lhr-solar/VCAT-MIKA/Hardware/MIKA/3D Models/TPS37A543222DSKRQ1.stp

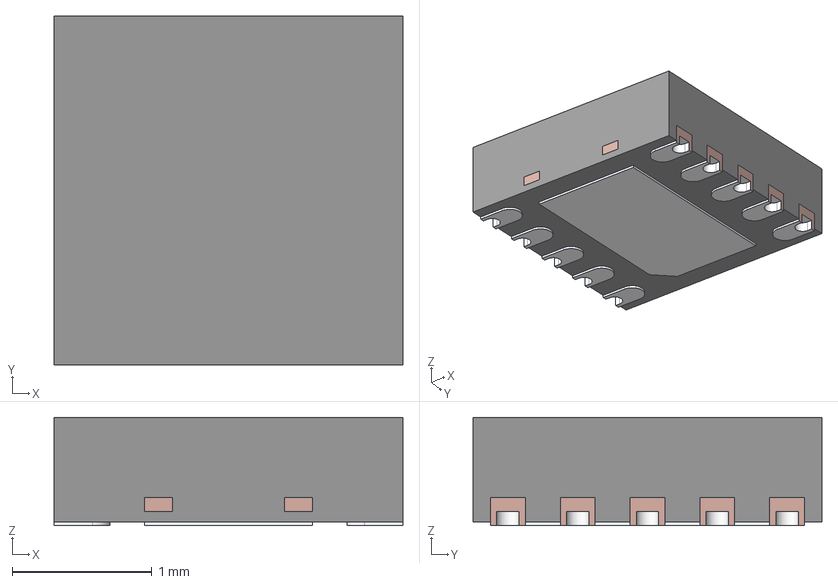
[picture p1: CAD file, 2026-10-27]
Hardware/MIKA/3D Models/TPS37A543222DSKRQ1.stp
2.50 x 2.50 x 0.775 mm
BODY-SON
FRAME-DSK0010C
