lhr-solar/VCAT-MIKA/Hardware/MIKA/3D Models/TPS2557QDRBTQ1.stp

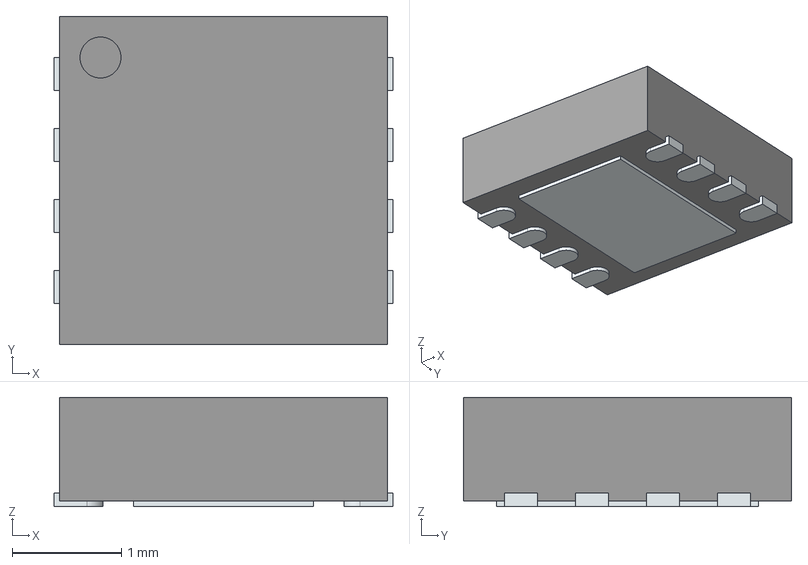
[picture p2: CAD file, 2026-10-13]
Hardware/MIKA/3D Models/TPS2557QDRBTQ1.stp
3.10 x 3.00 x 1.00 mm
ThermalPin
PinsArrayLR
