lhr-solar/VCAT-MIKA/Hardware/MIKA/3D Models/TPS566238RQFR.stp

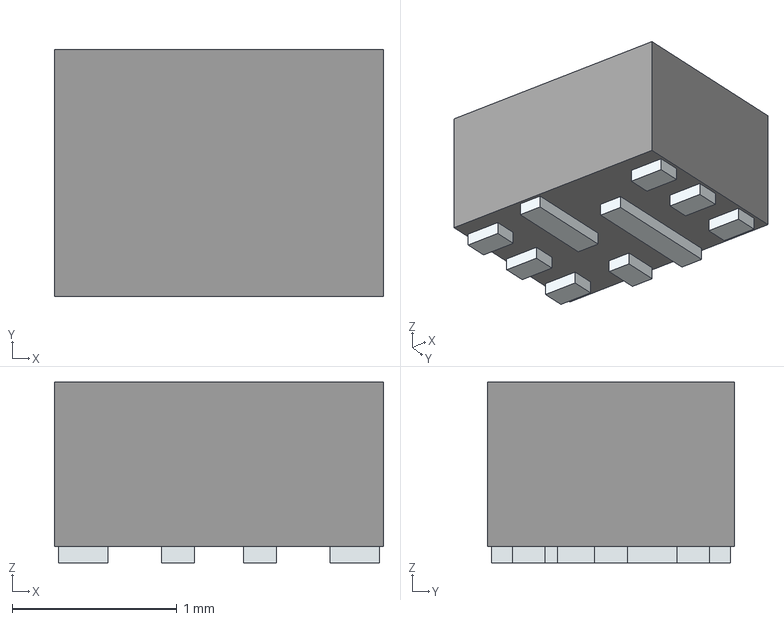
[picture p3: CAD file, 2026-10-27]
Hardware/MIKA/3D Models/TPS566238RQFR.stp
2.00 x 1.50 x 1.10 mm
Pins
