lhr-solar/VCAT-MIKA/Hardware/MIKA/3D Models/TPS259480AYWPR.stp

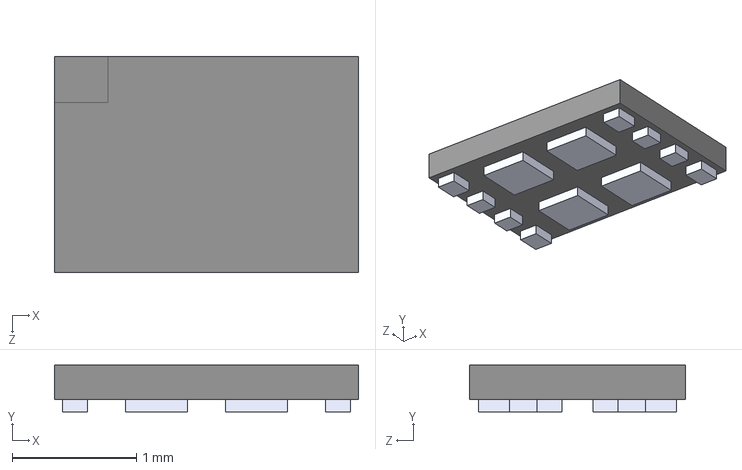
[picture p4: CAD file, 2026-10-27]
Hardware/MIKA/3D Models/TPS259480AYWPR.stp
2.45 x 0.376 x 1.74 mm
