lhr-solar/VCAT-MIKA/Hardware/MIKA/3D Models/TPS56628DDAR.stp

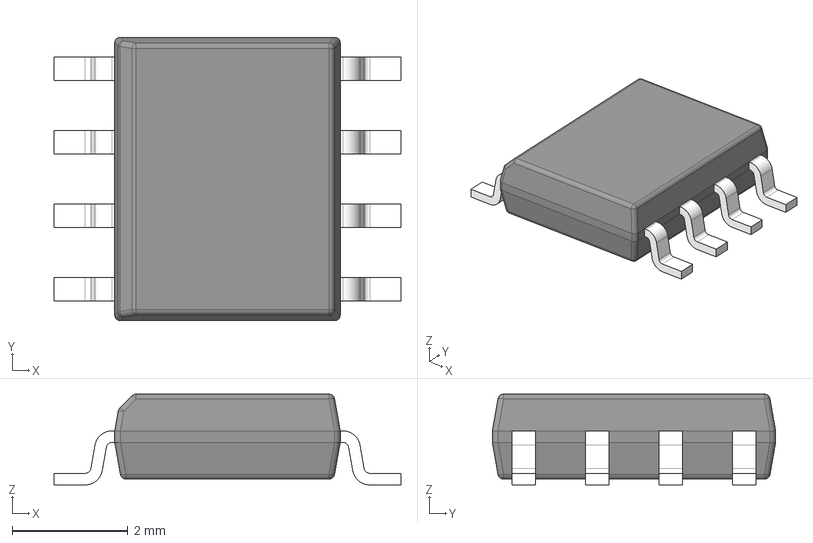
[picture p5: CAD file, 2026-10-27]
Hardware/MIKA/3D Models/TPS56628DDAR.stp
6.00 x 4.90 x 1.57 mm
BODY-SO
LEAD-SO x 8
THERMALPAD-SO
