lhr-solar/VCAT-MIKA/Hardware/MIKA/12V_buck_5A.kicad_sch

## KiCad design Hardware/MIKA/12V_buck_5A.kicad_sch (2026-10-31)

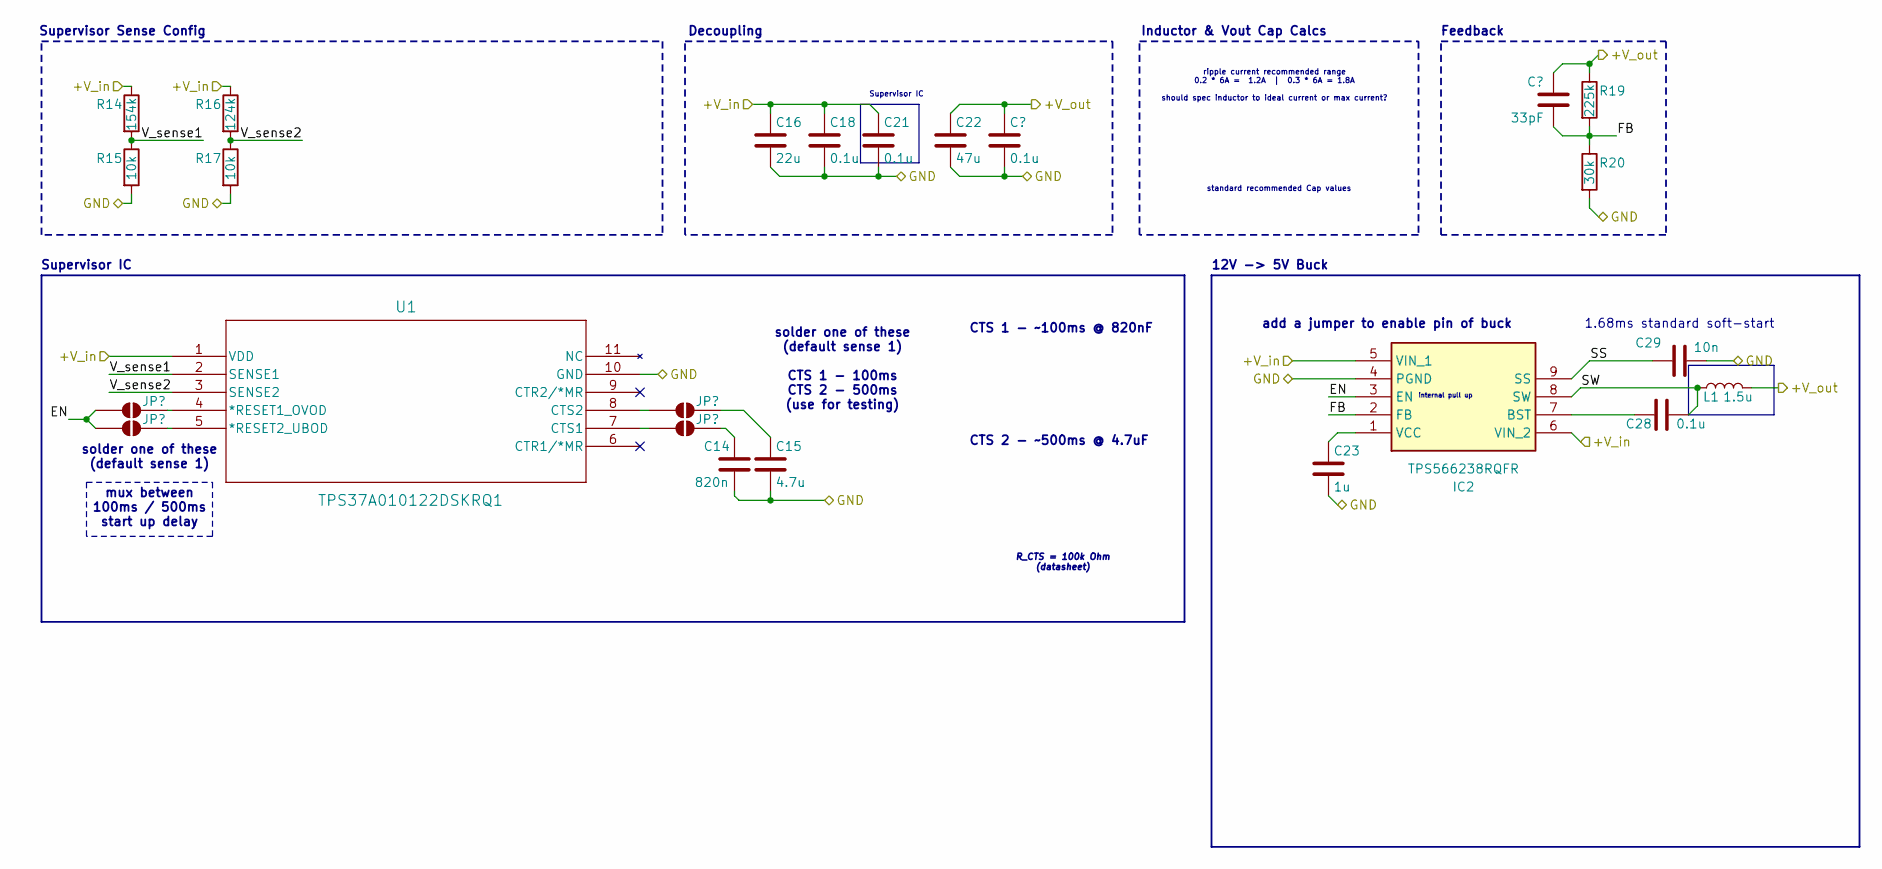
[picture p6: schematic 12V_buck_5A.kicad_sch]

Parts:
C14: 820n
C15: 4.7u
C16: 22u
C18, C21, C28: 0.1u
C22: 47u
C23: 1u
C29: 10n
IC2: TPS566238RQFR; Mouser Part Number 595-TPS566238RQFR
L1: 1.5u
R14: 154k
R15, R17: 10k
R16: 124k
R19: 225k
R20: 30k
U1: TPS37A010122DSKRQ1; SON10_DSK_TEX

Connections:
+V_in: C16.1, C18.1, C21.1, IC2.5 (VIN_1), IC2.6 (VIN_2), R14.1, R16.1, U1.1 (VDD)
+V_out: C22.1, L1.2, R19.1
EN: IC2.3 (EN)
FB: IC2.2 (FB), R19.2, R20.1
GND: C14.2, C15.2, C16.2, C18.2, C21.2, C22.2, C23.2, C29.1, IC2.4 (PGND), R15.2, R17.2, R20.2, U1.10 (GND)
unnamed: C23.1, IC2.1 (VCC)
unnamed: C28.1, IC2.7 (BST)
SS: C29.2, IC2.9 (SS)
SW: C28.2, IC2.8 (SW), L1.1
V_sense1: R14.2, R15.1, U1.2 (SENSE1)
V_sense2: R16.2, R17.1, U1.3 (SENSE2)

Notes on the sheet:
Supervisor IC
Feedback
solder one of these (default sense 1) CTS 1 - 100ms CTS 2 - 500ms (use for testing)
Decoupling
standard recommended Cap values
Inductor & Vout Cap Calcs
R_CTS = 100k Ohm (datasheet)
Supervisor Sense Config
12V -> 5V Buck
CTS 1 - ~100ms @ 820nF
ripple current recommended range 0.2 * 6A = 1.2A | 0.3 * 6A = 1.8A should spec inductor to ideal current or max current?
solder one of these (default sense 1) mux between 100ms / 500ms start up delay
1.68ms standard soft-start
internal pull up
add a jumper to enable pin of buck
CTS 2 - ~500ms @ 4.7uF
