lhr-solar/VCAT-MIKA/Hardware/MIKA/CM5.kicad_sch

## KiCad design Hardware/MIKA/CM5.kicad_sch (2026-10-31)

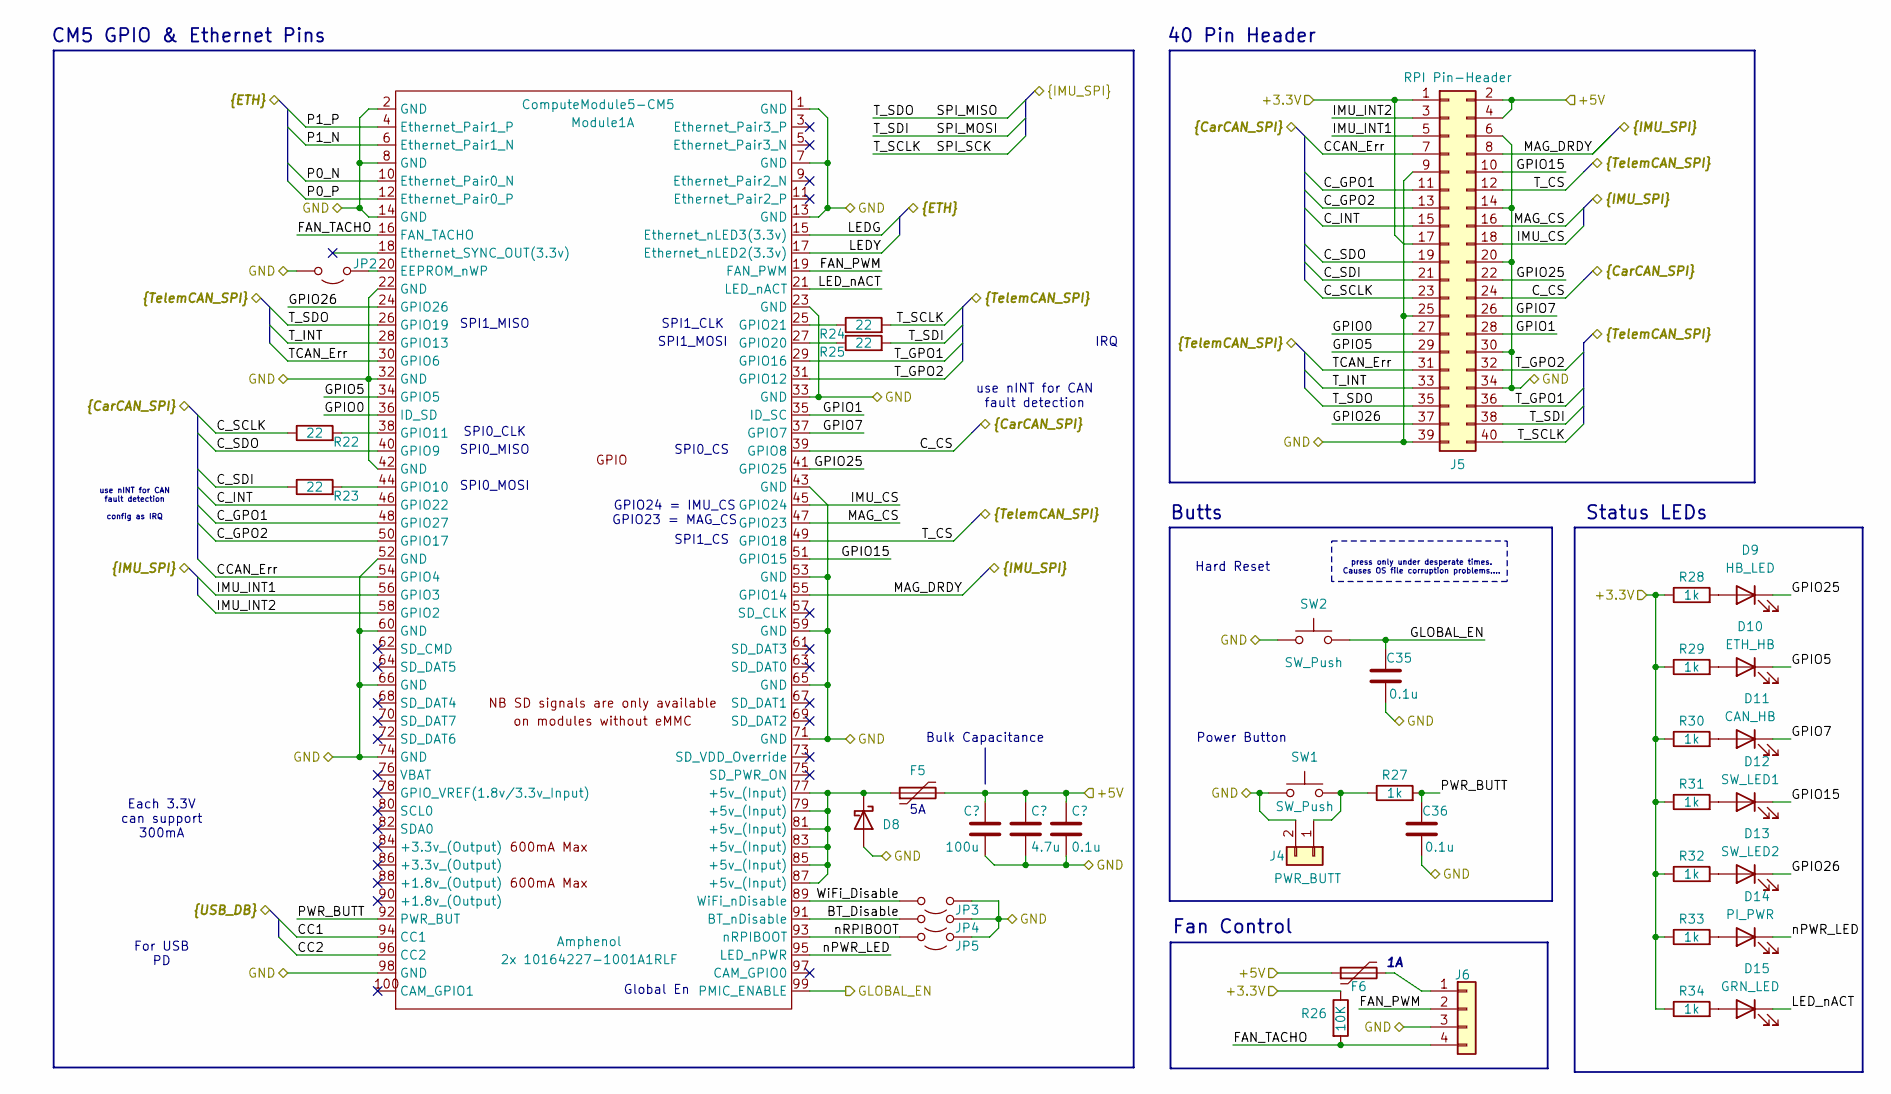
[picture p7: schematic CM5.kicad_sch]

Parts:
C35, C36: 0.1u
D8: D_Schottky
D9: HB_LED
D10: ETH_HB
D11: CAN_HB
D12: SW_LED1
D13: SW_LED2
D14: PI_PWR
D15: GRN_LED
F5, F6: Polyfuse
J4: PWR_BUTT
J5: RPI Pin-Header; PinSocket_2x20_P2.54mm_Vertical; JLC N/A
J6: Fan Header; JST_SH_BM04B-SRSS-TB_1x04-1MP_P1.00mm_Vertical; Part Description 4 pin vertical 1mm pitch connector; JLC N/A
JP2, JP3, JP4, JP5: Jumper_2_Open
Module1: ComputeModule5-CM5; Raspberry-Pi-5-Compute-Module
R22, R23, R24, R25: 22
R26: 10K
R27, R28, R29, R30, R31, R32, R33, R34: 1k
SW1, SW2: SW_Push

Connections:
+3.3V: J5.1, J5.17, R26.1, R28.1, R29.1, R30.1, R31.1, R32.1, R33.1, R34.1
+5V: F5.2, F6.1, J5.2, J5.4
BT_Disable: JP4.2 (B), Module1.91 (BT_nDisable)
CC1: Module1.94 (CC1)
CC2: Module1.96 (CC2)
CCAN_Err: J5.7, Module1.54 (GPIO4)
C_CS: J5.24, Module1.39 (GPIO8)
C_GPO1: J5.11, Module1.48 (GPIO27)
C_GPO2: J5.13, Module1.50 (GPIO17)
C_INT: J5.15, Module1.46 (GPIO22)
C_SCLK: J5.23, R22.1
C_SDI: J5.21, R23.1
C_SDO: J5.19, Module1.40 (GPIO9)
FAN_PWM: J6.2, Module1.19 (FAN_PWM)
FAN_TACHO: J6.4, Module1.16 (FAN_TACHO), R26.2
GLOBAL_EN: C35.2, Module1.99 (PMIC_ENABLE), SW2.2
GND: C35.1, C36.1, D8.2 (A), J4.2, J5.6, J5.9, J5.14, J5.20, J5.25, J5.30, J5.34, J5.39, J6.3, JP2.2 (B), JP3.1 (A), JP4.1 (A), JP5.1 (A), Module1.1 (GND), Module1.2 (GND), Module1.7 (GND), Module1.8 (GND), Module1.13 (GND), Module1.14 (GND), Module1.22 (GND), Module1.23 (GND), Module1.32 (GND), Module1.33 (GND), Module1.42 (GND), Module1.43 (GND), Module1.52 (GND), Module1.53 (GND), Module1.59 (GND), Module1.60 (GND), Module1.65 (GND), Module1.66 (GND), Module1.71 (GND), Module1.74 (GND), Module1.98 (GND), SW1.1, SW2.1
GPIO0: J5.27, Module1.36 (ID_SD)
GPIO1: J5.28, Module1.35 (ID_SC)
GPIO5: D10.1 (K), J5.29, Module1.34 (GPIO5)
GPIO7: D11.1 (K), J5.26, Module1.37 (GPIO7)
GPIO15: D12.1 (K), J5.10, Module1.51 (GPIO15)
GPIO25: D9.1 (K), J5.22, Module1.41 (GPIO25)
GPIO26: D13.1 (K), J5.37, Module1.24 (GPIO26)
IMU_CS: J5.18, Module1.45 (GPIO24)
IMU_INT1: J5.5, Module1.56 (GPIO3)
IMU_INT2: J5.3, Module1.58 (GPIO2)
LEDG: Module1.15 (Ethernet_nLED3(3.3v))
LEDY: Module1.17 (Ethernet_nLED2(3.3v))
LED_nACT: D15.1 (K), Module1.21 (LED_nACT)
MAG_CS: J5.16, Module1.47 (GPIO23)
MAG_DRDY: J5.8, Module1.55 (GPIO14)
unnamed: D8.1 (K), F5.1, Module1.77 (+5v_(Input)), Module1.79 (+5v_(Input)), Module1.81 (+5v_(Input)), Module1.83 (+5v_(Input)), Module1.85 (+5v_(Input)), Module1.87 (+5v_(Input))
unnamed: D9.2 (A), R28.2
unnamed: D10.2 (A), R29.2
unnamed: D11.2 (A), R30.2
unnamed: D12.2 (A), R31.2
unnamed: D13.2 (A), R32.2
unnamed: D14.2 (A), R33.2
unnamed: D15.2 (A), R34.2
unnamed: F6.2, J6.1
unnamed: J4.1, R27.1, SW1.2
unnamed: JP2.1 (A), Module1.20 (EEPROM_nWP)
unnamed: Module1.25 (GPIO21), R24.1
unnamed: Module1.27 (GPIO20), R25.1
unnamed: Module1.38 (GPIO11), R22.2
unnamed: Module1.44 (GPIO10), R23.2
P0_N: Module1.10 (Ethernet_Pair0_N)
P0_P: Module1.12 (Ethernet_Pair0_P)
P1_N: Module1.6 (Ethernet_Pair1_N)
P1_P: Module1.4 (Ethernet_Pair1_P)
PWR_BUTT: C36.2, Module1.92 (PWR_BUT), R27.2
SPI_MISO: J5.35, Module1.26 (GPIO19)
SPI_MOSI: J5.38, R25.2
SPI_SCK: J5.40, R24.2
TCAN_Err: J5.31, Module1.30 (GPIO6)
T_CS: J5.12, Module1.49 (GPIO18)
T_GPO1: J5.36, Module1.29 (GPIO16)
T_GPO2: J5.32, Module1.31 (GPIO12)
T_INT: J5.33, Module1.28 (GPIO13)
WiFi_Disable: JP3.2 (B), Module1.89 (WiFi_nDisable)
nPWR_LED: D14.1 (K), Module1.95 (LED_nPWR)
nRPIBOOT: JP5.2 (B), Module1.93 (nRPIBOOT)

Notes on the sheet:
IRQ
SPI0_CLK
40 Pin Header
Each 3.3V can support 300mA
SPI1_CS
Fan Control
SPI0_MISO
CM5 GPIO & Ethernet Pins
SPI1_CLK
Power Button
SPI1_MOSI
press only under desperate times. Causes OS file corruption problems....
use nINT for CAN fault detection config as IRQ
Butts
Bulk Capacitance
SPI1_MISO
Global En
Hard Reset
For USB PD
SPI0_CS
GPIO24 = IMU_CS GPIO23 = MAG_CS
use nINT for CAN fault detection
SPI0_MOSI
Status LEDs
