lhr-solar/VCAT-MIKA/Hardware/MIKA/IMUs.kicad_sch

## KiCad design Hardware/MIKA/IMUs.kicad_sch (2026-10-27)

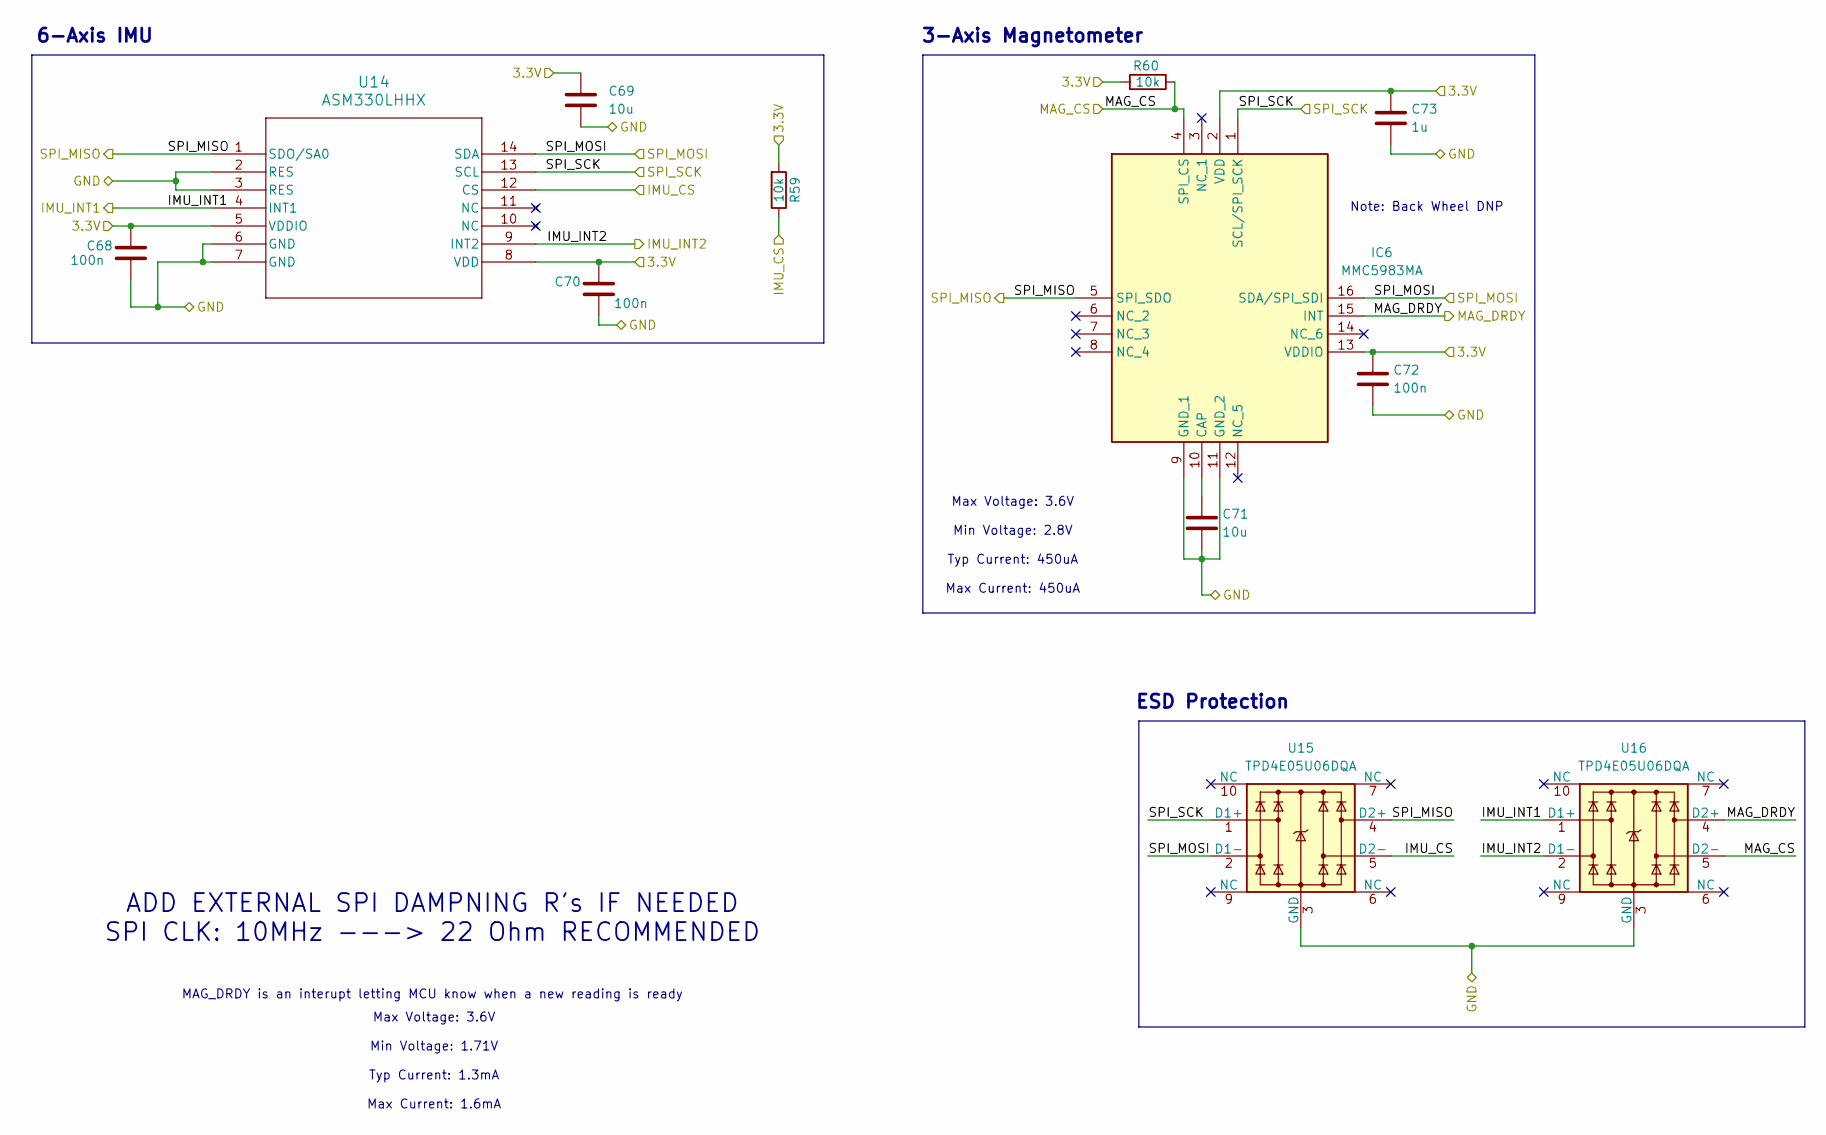
[picture p8: schematic IMUs.kicad_sch]

Parts:
C68, C70, C72: 100n; C_0603_1608Metric_Pad1.08x0.95mm_HandSolder
C69: 10u; Balun_Johanson_0900PC15J0013
C71: 10u; C_0603_1608Metric_Pad1.08x0.95mm_HandSolder
C73: 1u; C_0603_1608Metric_Pad1.08x0.95mm_HandSolder
IC6: MMC5983MA; Mouser Part Number 438-MMC5983MA
R59, R60: 10k; R_0603_1608Metric_Pad0.98x0.95mm_HandSolder
U14: ASM330LHHX; LGA14_ASM330_STM
U15, U16: TPD4E05U06DQA; USON-10_2.5x1.0mm_P0.5mm

Connections:
3.3V: C68.1, C69.1, C70.1, C72.1, C73.1, IC6.2 (VDD), IC6.13 (VDDIO), R59.2, R60.2, U14.5 (VDDIO), U14.8 (VDD)
GND: C68.2, C69.2, C70.2, C71.2, C72.2, C73.2, IC6.9 (GND_1), IC6.11 (GND_2), U14.2 (RES), U14.3 (RES), U14.6 (GND), U14.7 (GND), U15.3 (GND), U15.8 (GND), U16.3 (GND), U16.8 (GND)
IMU_CS: R59.1, U14.12 (CS), U15.5 (D2-)
IMU_INT1: U14.4 (INT1), U16.1 (D1+)
IMU_INT2: U14.9 (INT2), U16.2 (D1-)
MAG_CS: IC6.4 (SPI_CS), R60.1, U16.5 (D2-)
MAG_DRDY: IC6.15 (INT), U16.4 (D2+)
unnamed: C71.1, IC6.10 (CAP)
SPI_MISO: IC6.5 (SPI_SDO), U14.1 (SDO/SA0), U15.4 (D2+)
SPI_MOSI: IC6.16 (SDA/SPI_SDI), U14.14 (SDA), U15.2 (D1-)
SPI_SCK: IC6.1 (SCL/SPI_SCK), U14.13 (SCL), U15.1 (D1+)

Notes on the sheet:
Max Voltage: 3.6V Min Voltage: 1.71V Typ Current: 1.3mA Max Current: 1.6mA
Max Voltage: 3.6V Min Voltage: 2.8V Typ Current: 450uA Max Current: 450uA
MAG_DRDY is an interupt letting MCU know when a new reading is ready
3-Axis Magnetometer
6-Axis IMU
ESD Protection
Note: Back Wheel DNP
ADD EXTERNAL SPI DAMPNING R's IF NEEDED SPI CLK: 10MHz ---> 22 Ohm RECOMMENDED
