lhr-solar/VCAT-MIKA/Hardware/MIKA/LDO.kicad_sch

## KiCad design Hardware/MIKA/LDO.kicad_sch (2026-10-27)

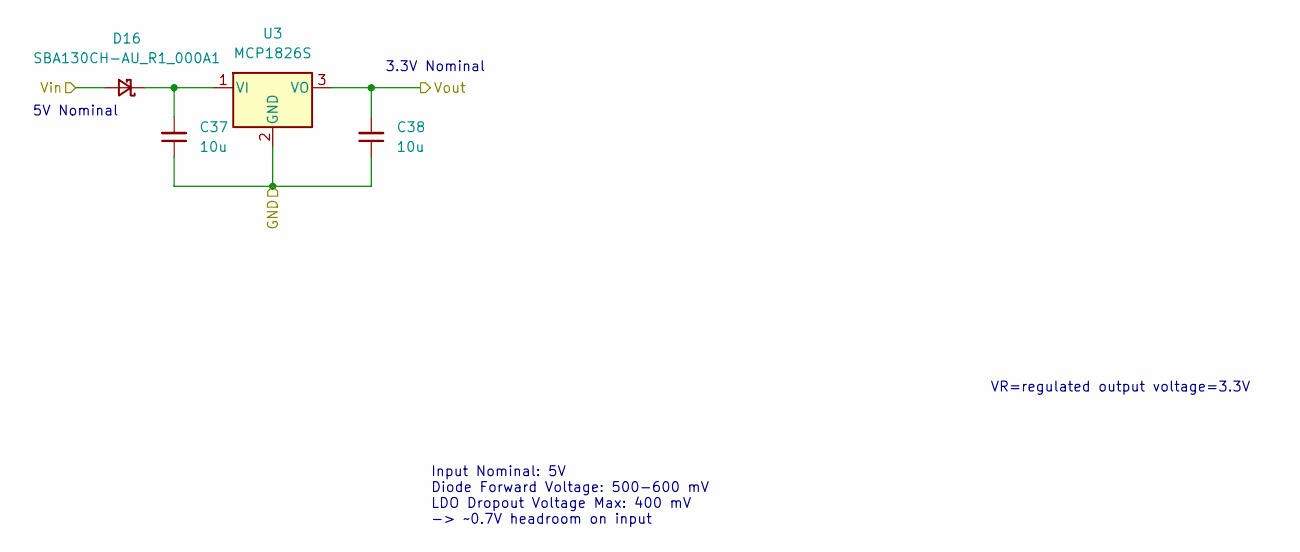
[picture p9: schematic LDO.kicad_sch]

Parts:
C37, C38: 10u; C_0805_2012Metric_Pad1.18x1.45mm_HandSolder; Mouser P/N GRM21BR61H106KE43K
D16: SBA130CH-AU_R1_000A1; D_SOD-323_HandSoldering; LCSC P/N C191023
U3: MCP1826S; SOT-223-3_TabPin2; LCSC P/N C126055

Connections:
GND: C37.1, C38.1, U3.2 (GND)
unnamed: C37.2, D16.1 (K), U3.1 (VI)
Vin: D16.2 (A)
Vout: C38.2, U3.3 (VO)

Notes on the sheet:
5V Nominal
Input Nominal: 5V Diode Forward Voltage: 500-600 mV LDO Dropout Voltage Max: 400 mV -> ~0.7V headroom on input
VR=regulated output voltage=3.3V
3.3V Nominal
