lhr-solar/VCAT-MIKA/Hardware/MIKA/PowerProtection.kicad_sch

## KiCad design Hardware/MIKA/PowerProtection.kicad_sch (2026-10-27)

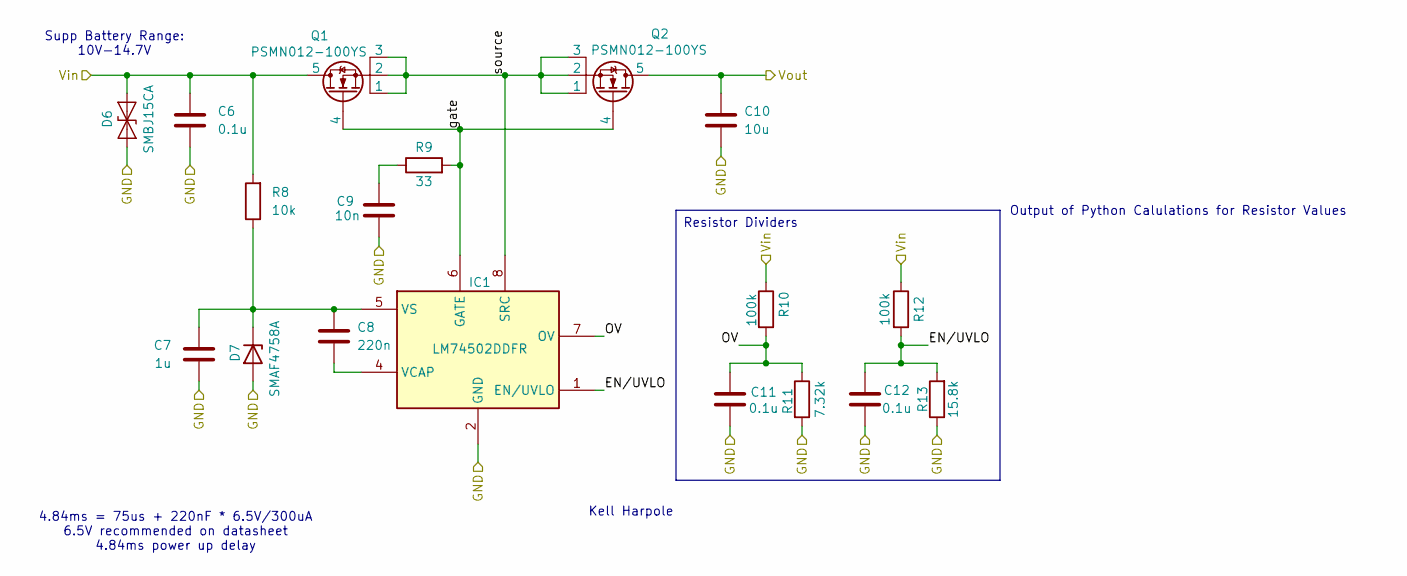
[picture p10: schematic PowerProtection.kicad_sch]

Parts:
C6, C11, C12: 0.1u; C_0603_1608Metric_Pad1.08x0.95mm_HandSolder; LCSC P/N C1591
C7: 1u; C_0603_1608Metric_Pad1.08x0.95mm_HandSolder; LCSC P/N C559769
C8: 220n; C_0603_1608Metric_Pad1.08x0.95mm_HandSolder; LCSC P/N C107083
C9: 10n; C_0603_1608Metric_Pad1.08x0.95mm_HandSolder; LCSC P/N C100042
C10: 10u; C_0805_2012Metric_Pad1.18x1.45mm_HandSolder; LCSC P/N C440198
D6: SMBJ15CA; D_SMB; LCSC P/N C669039
D7: SMAF4758A; SODFL5026X125N; LCSC P/N C183490
IC1: LM74502DDFR; LCSC P/N C3236215
Q1, Q2: PSMN012-100YS; LFPAK56; LCSC P/N C20443035
R8: 10k; R_0603_1608Metric_Pad0.98x0.95mm_HandSolder; LCSC P/N C25804
R9: 33; R_0603_1608Metric_Pad0.98x0.95mm_HandSolder; LCSC P/N C2074308
R10, R12: 100k; R_0603_1608Metric_Pad0.98x0.95mm_HandSolder; LCSC P/N C25803
R11: 7.32k; R_0603_1608Metric_Pad0.98x0.95mm_HandSolder; LCSC P/N C862286
R13: 15.8k; R_0603_1608Metric_Pad0.98x0.95mm_HandSolder; LCSC P/N C843918

Connections:
EN/UVLO: C12.1, IC1.1 (EN/UVLO), R12.2, R13.2
GND: C6.2, C7.1, C9.2, C10.2, C11.2, C12.2, D6.1 (A1), D7.2 (A), IC1.2 (GND), R11.2, R13.1
unnamed: C7.2, C8.1, D7.1 (K), IC1.5 (VS), R8.1
unnamed: C8.2, IC1.4 (VCAP)
unnamed: C9.1, R9.1
OV: C11.1, IC1.7 (OV), R10.2, R11.1
Vin: C6.1, D6.2 (A2), Q1.5, R8.2, R10.1, R12.1
Vout: C10.1, Q2.5
gate: IC1.6 (GATE), Q1.4, Q2.4, R9.2
source: IC1.8 (SRC), Q1.1, Q1.2, Q1.3, Q2.1, Q2.2, Q2.3

Notes on the sheet:
4.84ms = 75us + 220nF * 6.5V/300uA 6.5V recommended on datasheet 4.84ms power up delay
Output of Python Calulations for Resistor Values
Kell Harpole
Supp Battery Range: 10V-14.7V
Resistor Dividers
