lhr-solar/VCAT-MIKA/Hardware/MIKA/Power_Mux.kicad_sch

## KiCad design Hardware/MIKA/Power_Mux.kicad_sch (2026-10-27)

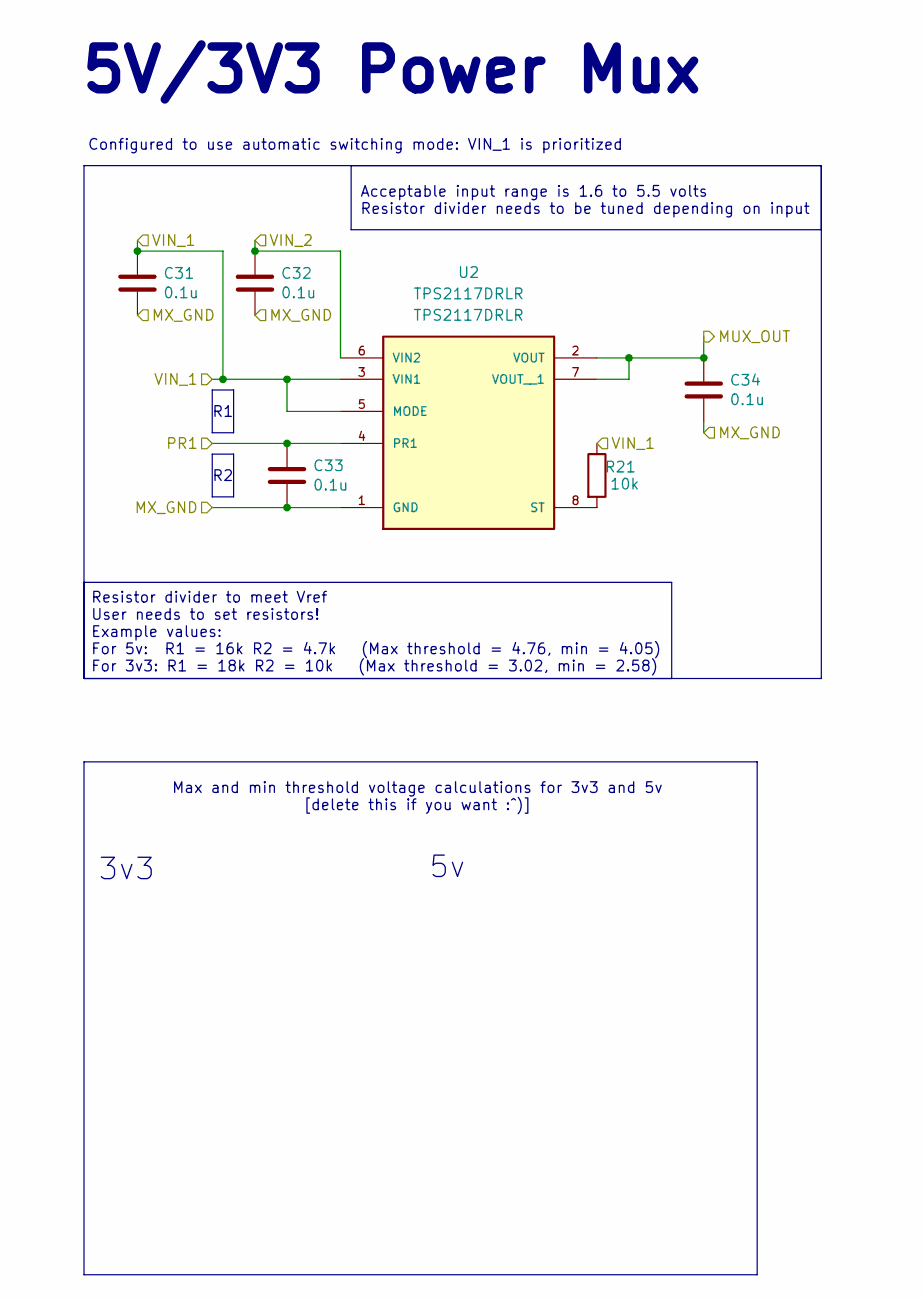
[picture p11: schematic Power_Mux.kicad_sch]

Parts:
C31, C32, C33, C34: 0.1u; C_0603_1608Metric_Pad1.08x0.95mm_HandSolder
R21: 10k; R_0603_1608Metric_Pad0.98x0.95mm_HandSolder
U2: TPS2117DRLR

Connections:
MUX_OUT: C34.1, U2.2 (VOUT), U2.7 (VOUT__1)
MX_GND: C31.2, C32.2, C33.2, C34.2, U2.1 (GND)
unnamed: R21.2, U2.8 (ST)
PR1: C33.1, U2.4 (PR1)
VIN_1: C31.1, R21.1, U2.3 (VIN1), U2.5 (MODE)
VIN_2: C32.1, U2.6 (VIN2)

Notes on the sheet:
Max and min threshold voltage calculations for 3v3 and 5v [delete this if you want :^)]
3v3
Configured to use automatic switching mode: VIN_1 is prioritized
Acceptable input range is 1.6 to 5.5 volts Resistor divider needs to be tuned depending on input
Resistor divider to meet Vref User needs to set resistors! Example values: For 5v: R1 = 16k R2 = 4.7k (Max threshold = 4.76, min = 4.05) For 3v3: R1 = 18k R2 = 10k (Max threshold = 3.02, min = 2.58)
5V/3V3 Power Mux
