lhr-solar/VCAT-MIKA/Hardware/MIKA/SPI_CAN.kicad_sch

## KiCad design Hardware/MIKA/SPI_CAN.kicad_sch (2026-10-27)

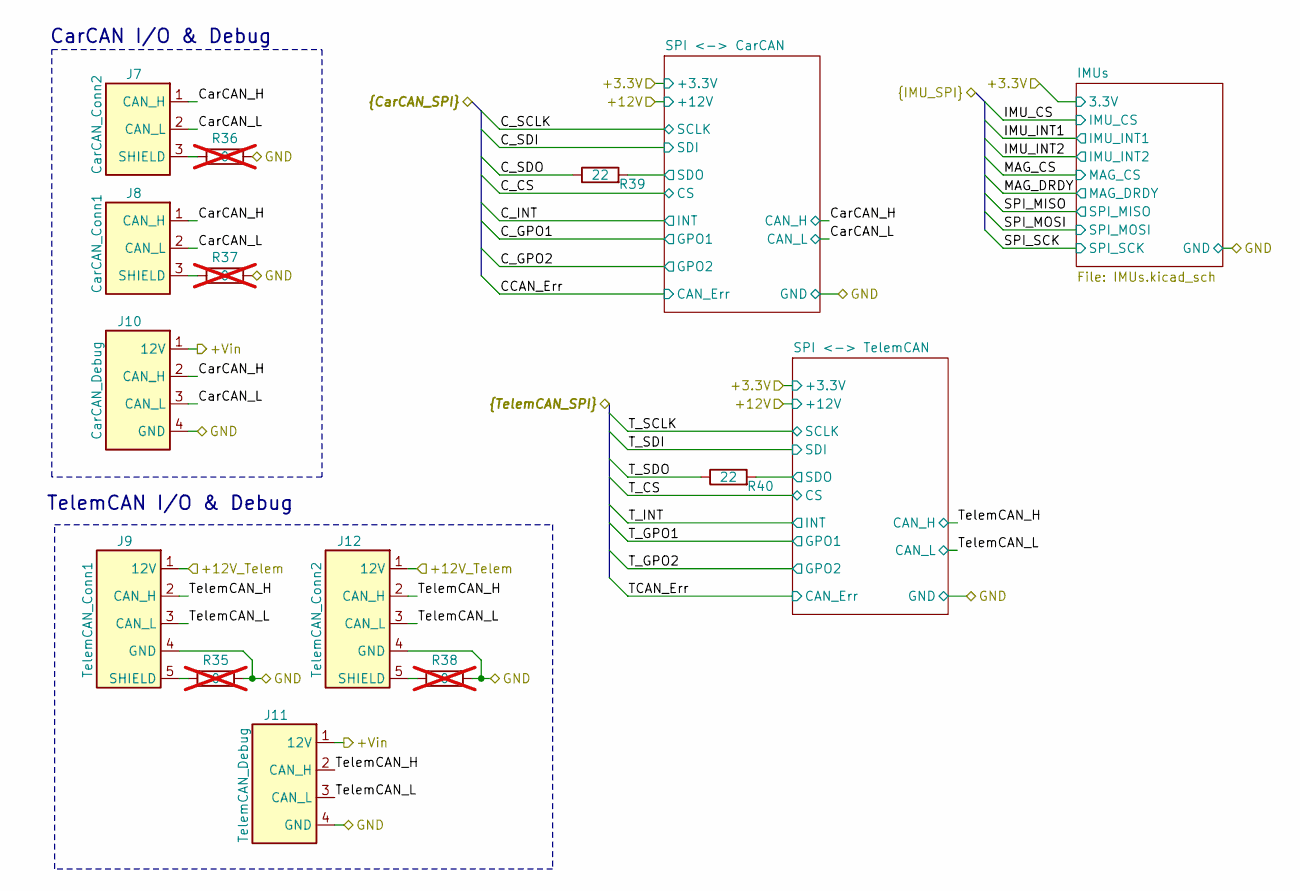
[picture p12: schematic SPI_CAN.kicad_sch]

Parts:
J7: CarCAN_Conn2; Molex_Nano-Fit_105309-xx03_1x03_P2.50mm_Vertical
J8: CarCAN_Conn1; Molex_Nano-Fit_105309-xx03_1x03_P2.50mm_Vertical
J9: TelemCAN_Conn1; Molex_Nano-Fit_105309-xx05_1x05_P2.50mm_Vertical
J10: CarCAN_Debug; Molex_Nano-Fit_105309-xx05_1x04_P2.50mm_Vertical
J11: TelemCAN_Debug; Molex_Nano-Fit_105309-xx05_1x04_P2.50mm_Vertical
J12: TelemCAN_Conn2; Molex_Nano-Fit_105309-xx05_1x05_P2.50mm_Vertical
R35, R36, R37, R38: 0; not fitted
R39, R40: 22

Connections:
+12V_Telem: J9.1 (12V), J12.1 (12V)
+Vin: J10.1 (12V), J11.1 (12V)
C_SDO: R39.1
CarCAN_H: J7.1 (CAN_H), J8.1 (CAN_H), J10.2 (CAN_H)
CarCAN_L: J7.2 (CAN_L), J8.2 (CAN_L), J10.3 (CAN_L)
GND: J9.4 (GND), J10.4 (GND), J11.4 (GND), J12.4 (GND), R35.1, R36.1, R37.1, R38.1
unnamed: J7.3 (SHIELD), R36.2
unnamed: J8.3 (SHIELD), R37.2
unnamed: J9.5 (SHIELD), R35.2
unnamed: J12.5 (SHIELD), R38.2
SDO: R39.2, R40.2
T_SDO: R40.1
TelemCAN_H: J9.2 (CAN_H), J11.2 (CAN_H), J12.2 (CAN_H)
TelemCAN_L: J9.3 (CAN_L), J11.3 (CAN_L), J12.3 (CAN_L)

Notes on the sheet:
TelemCAN I/O & Debug
CarCAN I/O & Debug
