lhr-solar/VCAT-MIKA/Hardware/MIKA/USB-C_Connector.kicad_sch

## KiCad design Hardware/MIKA/USB-C_Connector.kicad_sch (2026-10-31)

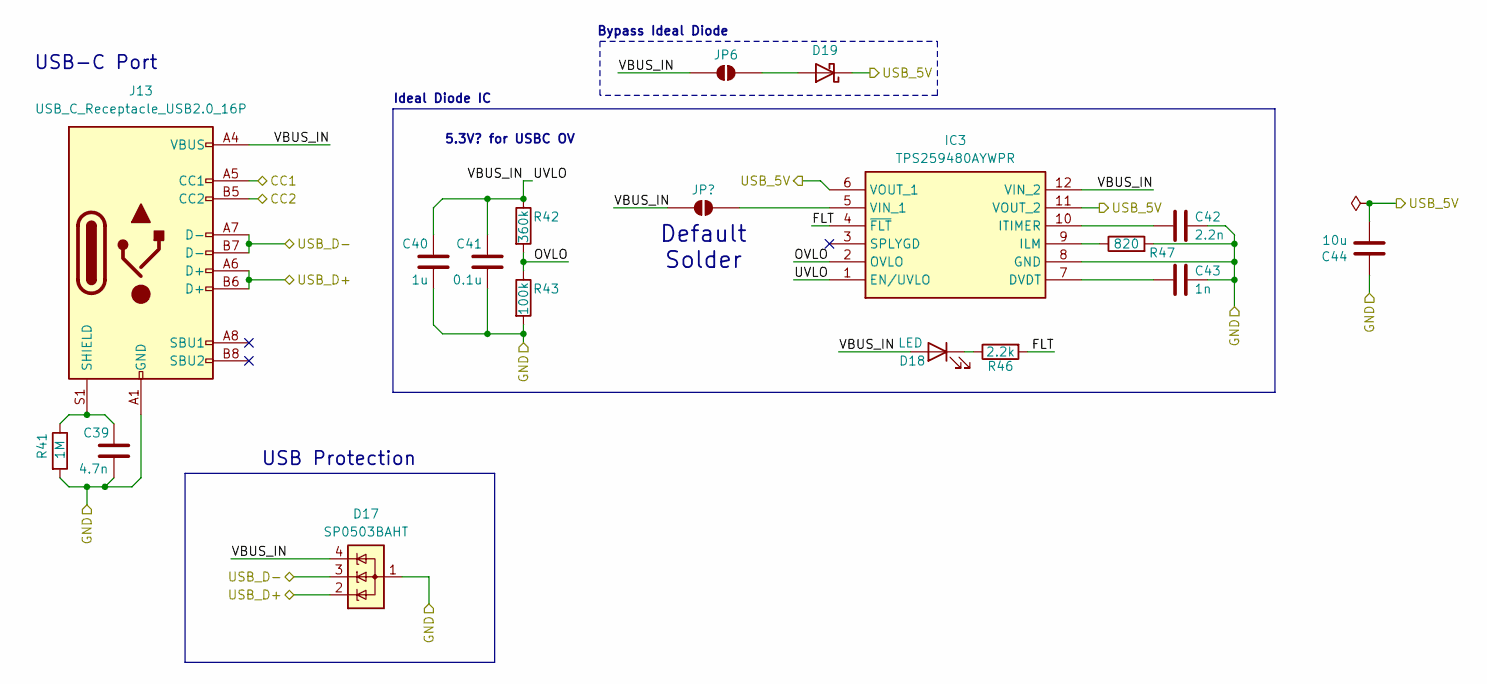
[picture p13: schematic USB-C_Connector.kicad_sch]

Parts:
C39: 4.7n
C40: 1u; C_0805_2012Metric; LCSC P/N C440198
C41: 0.1u; C_0805_2012Metric; LCSC P/N C440198
C42: 2.2n; C_0805_2012Metric; LCSC P/N C440198
C43: 1n; C_0805_2012Metric; LCSC P/N C440198
C44: 10u; C_0805_2012Metric; LCSC P/N C440198
D17: SP0503BAHT; SOT-143; Mouser Part Number 576-SP0503BAHTG
D18: LED; LED_0603_1608Metric
D19: D_Schottky; D_SOD-123; LCSC P/N C82544
IC3: TPS259480AYWPR; Mouser Part Number 595-TPS259480AYWPR
J13: USB_C_Receptacle_USB2.0_16P; USB_C_Receptacle_GCT_USB4105-xx-A_16P_TopMnt_Horizontal; LCSC P/N C3020560
JP6: SolderJumper_2_Open
R41: 1M
R42: 360k
R43: 100k
R46: 2.2k; R_0603_1608Metric_Pad0.98x0.95mm_HandSolder
R47: 820

Connections:
CC1: J13.A5 (CC1)
CC2: J13.B5 (CC2)
FLT: IC3.4 (~FLT), R46.2
GND: C39.2, C40.1, C41.1, C42.1, C43.1, C44.1, D17.1 (A), IC3.8 (GND), J13.A1 (GND), J13.A12 (GND), J13.B1 (GND), J13.B12 (GND), R41.2, R43.2, R47.2
unnamed: C39.1, J13.S1 (SHIELD), J13.S2 (Shield), J13.S3 (Shield), J13.S4 (Shield), R41.1
unnamed: C42.2, IC3.10 (ITIMER)
unnamed: C43.2, IC3.7 (DVDT)
unnamed: D18.1 (K), R46.1
unnamed: D19.2 (A), JP6.2 (B)
unnamed: IC3.9 (ILM), R47.1
OVLO: IC3.2 (OVLO), R42.2, R43.1
USB_5V: C44.2, D19.1 (K), IC3.6 (VOUT_1), IC3.11 (VOUT_2)
USB_D+: D17.2 (K), J13.A6 (D+), J13.B6 (D+)
USB_D-: D17.3 (K), J13.A7 (D-), J13.B7 (D-)
UVLO: C40.2, C41.2, D17.4 (K), D18.2 (A), IC3.1 (EN/UVLO), IC3.12 (VIN_2), J13.A4 (VBUS), J13.A9 (VBUS), J13.B4 (VBUS), J13.B9 (VBUS), JP6.1 (A), R42.1

Notes on the sheet:
USB Protection
Ideal Diode IC
Default Solder
Bypass Ideal Diode
USB-C Port
5.3V? for USBC OV
