lhr-solar/VCAT-MIKA/Hardware/MIKA/ethernet.kicad_sch

## KiCad design Hardware/MIKA/ethernet.kicad_sch (2026-10-27)

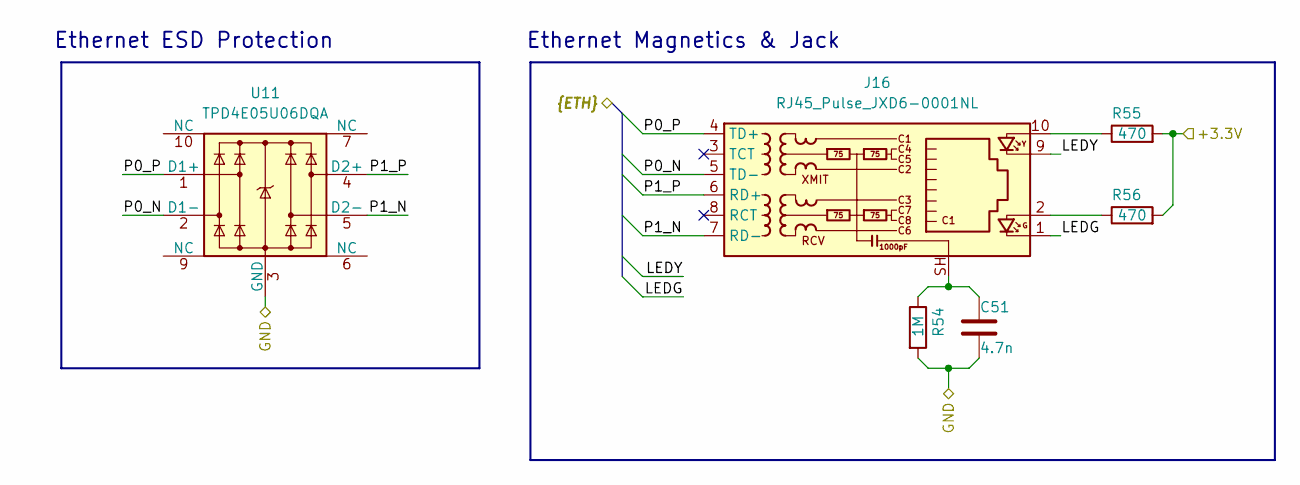
[picture p14: schematic ethernet.kicad_sch]

Parts:
C51: 4.7n
J16: RJ45_Pulse_JXD6-0001NL; RJ45_Pulse_JXD6-0001NL_Horizontal
R54: 1M
R55, R56: 470
U11: TPD4E05U06DQA; USON-10_2.5x1.0mm_P0.5mm

Connections:
+3.3V: R55.2, R56.2
GND: C51.2, R54.2, U11.3 (GND), U11.8 (GND)
LEDG: J16.1
LEDY: J16.9
unnamed: C51.1, J16.SH, R54.1
unnamed: J16.2, R56.1
unnamed: J16.10, R55.1
P0_N: J16.5 (TD-), U11.2 (D1-)
P0_P: J16.4 (TD+), U11.1 (D1+)
P1_N: J16.7 (RD-), U11.5 (D2-)
P1_P: J16.6 (RD+), U11.4 (D2+)

Notes on the sheet:
Ethernet Magnetics & Jack
Ethernet ESD Protection
