lhr-solar/VCAT-MIKA/Hardware/MIKA/hdmi_out.kicad_sch

## KiCad design Hardware/MIKA/hdmi_out.kicad_sch (2026-10-27)

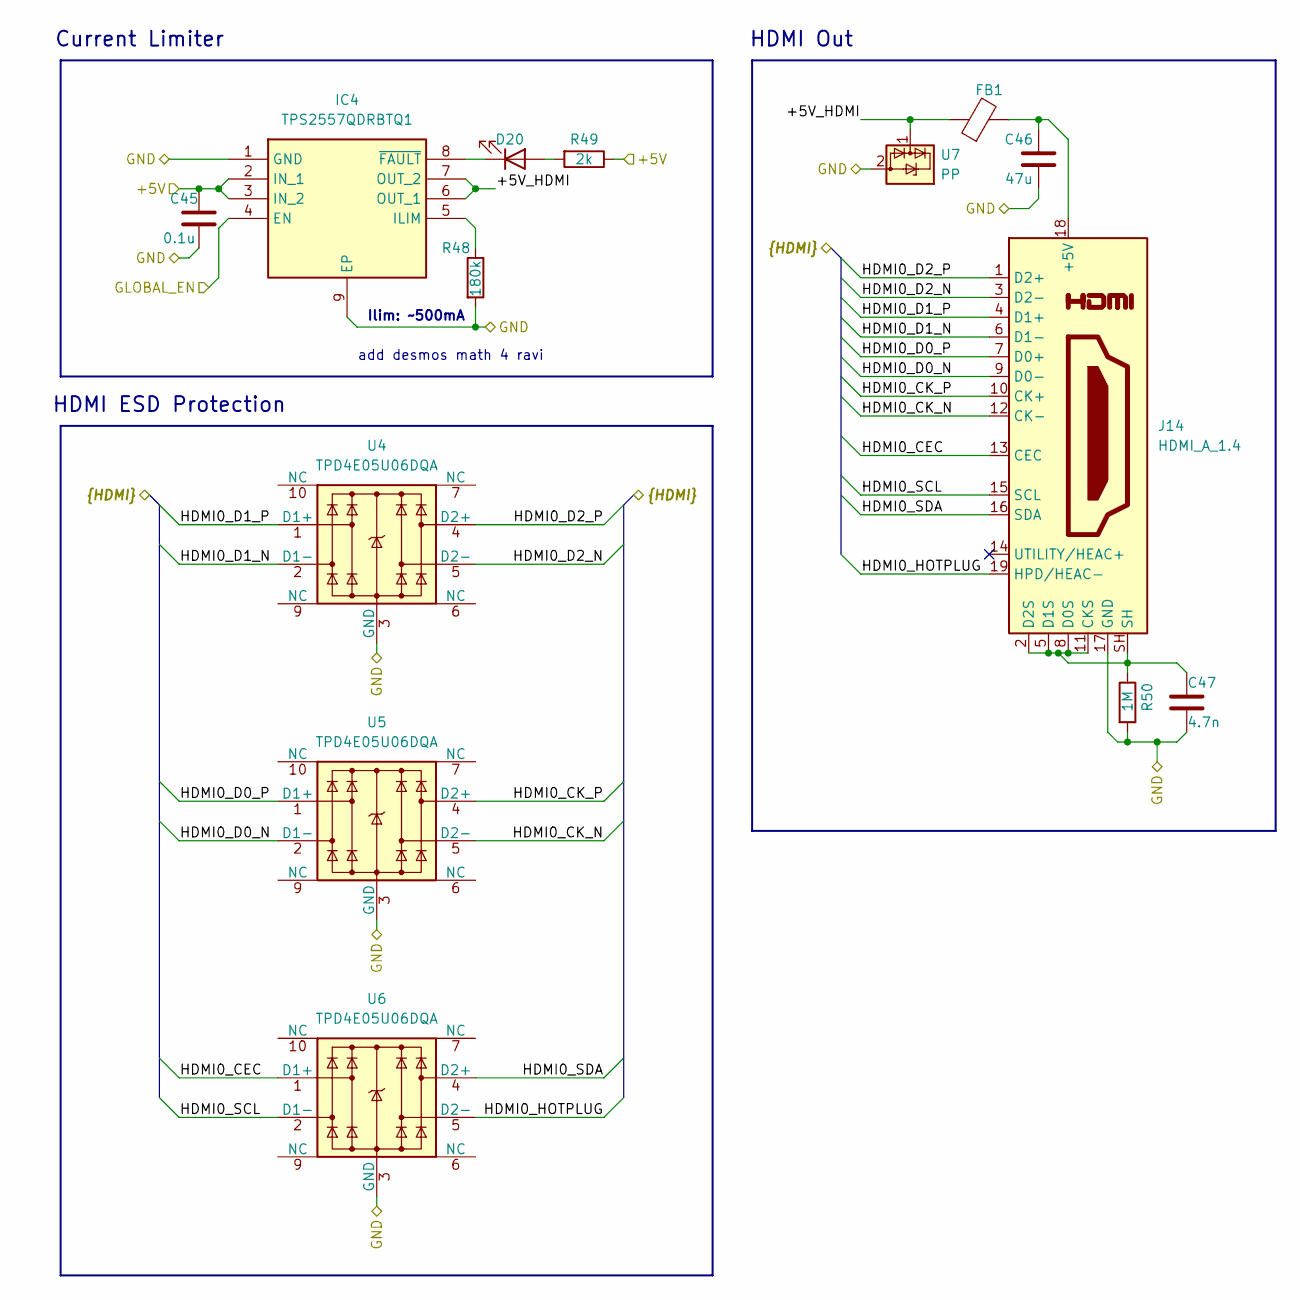
[picture p15: schematic hdmi_out.kicad_sch]

Parts:
C45: 0.1u
C46: 47u
C47: 4.7n
D20: LED
FB1: FerriteBead
IC4: TPS2557QDRBTQ1; SON65P300X300X100-9N-D; Mouser Part Number 595-TPS2557QDRBTQ1
J14: HDMI_A_1.4
R48: 180k
R49: 2k
R50: 1M
U4, U5, U6: TPD4E05U06DQA; USON-10_2.5x1.0mm_P0.5mm
U7: PP; D_SOD-523

Connections:
+5V: C45.2, IC4.2 (IN_1), IC4.3 (IN_2), R49.1
+5V_HDMI: FB1.1, IC4.6 (OUT_1), IC4.7 (OUT_2), U7.1 (I/O)
GLOBAL_EN: IC4.4 (EN)
GND: C45.1, C46.2, C47.2, IC4.1 (GND), IC4.9 (EP), J14.17 (GND), R48.2, R50.2, U4.3 (GND), U4.8 (GND), U5.3 (GND), U5.8 (GND), U6.3 (GND), U6.8 (GND), U7.2 (GND)
HDMI0_CEC: J14.13 (CEC), U6.1 (D1+)
HDMI0_CK_N: J14.12 (CK-), U5.5 (D2-)
HDMI0_CK_P: J14.10 (CK+), U5.4 (D2+)
HDMI0_D0_N: J14.9 (D0-), U5.2 (D1-)
HDMI0_D0_P: J14.7 (D0+), U5.1 (D1+)
HDMI0_D1_N: J14.6 (D1-), U4.2 (D1-)
HDMI0_D1_P: J14.4 (D1+), U4.1 (D1+)
HDMI0_D2_N: J14.3 (D2-), U4.5 (D2-)
HDMI0_D2_P: J14.1 (D2+), U4.4 (D2+)
HDMI0_HOTPLUG: J14.19 (HPD/HEAC-), U6.5 (D2-)
HDMI0_SCL: J14.15 (SCL), U6.2 (D1-)
HDMI0_SDA: J14.16 (SDA), U6.4 (D2+)
unnamed: C46.1, FB1.2, J14.18 (+5V)
unnamed: C47.1, J14.2 (D2S), J14.5 (D1S), J14.8 (D0S), J14.11 (CKS), J14.SH, R50.1
unnamed: D20.1 (K), IC4.8 (~FAULT)
unnamed: D20.2 (A), R49.2
unnamed: IC4.5 (ILIM), R48.1

Notes on the sheet:
HDMI ESD Protection
add desmos math 4 ravi
Ilim: ~500mA
HDMI Out
Current Limiter
