lhr-solar/VCAT-MIKA/Hardware/MIKA/power_regulation.kicad_sch

## KiCad design Hardware/MIKA/power_regulation.kicad_sch (2026-10-31)

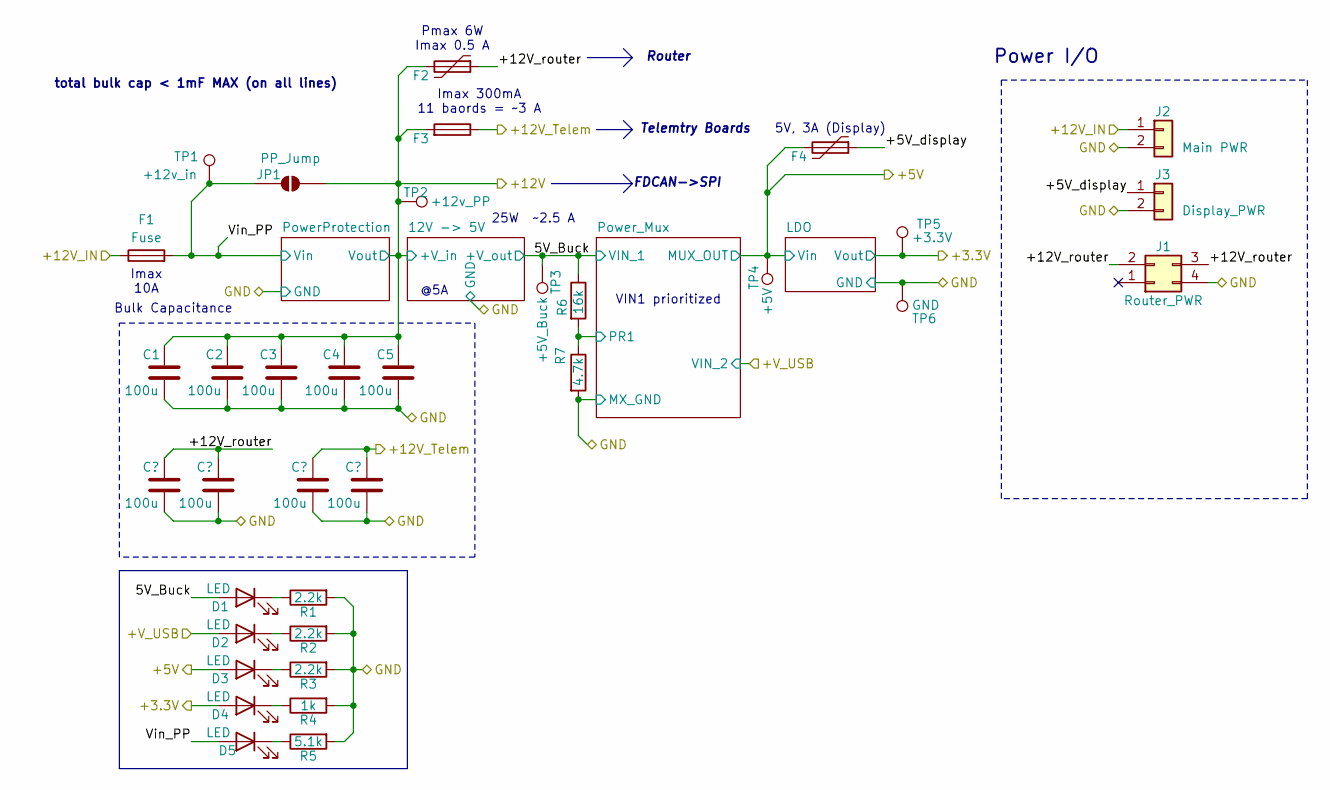
[picture p16: schematic power_regulation.kicad_sch]

Parts:
C1, C2, C3, C4, C5: 100u
D1, D2, D3, D4, D5: LED; LED_0603_1608Metric
F1, F3: Fuse; Fuse-3557-2
F2, F4: Polyfuse
J1: Router_PWR
J2: Main PWR
J3: Display_PWR
JP1: PP_Jump; SolderJumper-2_P1.3mm_Open_RoundedPad1.0x1.5mm
R1, R2, R3: 2.2k; R_0603_1608Metric_Pad0.98x0.95mm_HandSolder
R4: 1k; R_0603_1608Metric_Pad0.98x0.95mm_HandSolder
R5: 5.1k; R_0603_1608Metric_Pad0.98x0.95mm_HandSolder
R6: 16k
R7: 4.7k
TP1: +12v_in
TP2: +12v_PP
TP3: +5V_Buck
TP4: +5V
TP5: +3.3V
TP6: GND

Connections:
5V_Buck: D1.2 (A), R6.1, TP3.1
+3.3V: D4.2 (A), TP5.1
+5V: D3.2 (A), F4.2, TP4.1
+5V_display: F4.1, J3.1
+12V: C1.1, C2.1, C3.1, C4.1, C5.1, F2.2, F3.2, JP1.2 (B), TP2.1
+12V_IN: F1.1, J2.1
+12V_Telem: F3.1
+12V_router: F2.1, J1.2, J1.3
+V_USB: D2.2 (A)
GND: C1.2, C2.2, C3.2, C4.2, C5.2, J1.4, J2.2, J3.2, R1.2, R2.2, R3.2, R4.2, R5.2, R7.2, TP6.1
unnamed: D1.1 (K), R1.1
unnamed: D2.1 (K), R2.1
unnamed: D3.1 (K), R3.1
unnamed: D4.1 (K), R4.1
unnamed: D5.1 (K), R5.1
PR1: R6.2, R7.1
Vin_PP: D5.2 (A), F1.2, JP1.1 (A), TP1.1

Notes on the sheet:
Imax 10A
Telemtry Boards
VIN1 prioritized
Router
5V, 3A (Display)
total bulk cap < 1mF MAX (on all lines)
Imax 300mA 11 baords = ~3 A
@5A
Power I/O
25W ~2.5 A
Bulk Capacitance
Pmax 6W Imax 0.5 A
FDCAN->SPI
