lhr-solar/VCAT-MIKA/Hardware/MIKA/spi_2_can.kicad_sch

## KiCad design Hardware/MIKA/spi_2_can.kicad_sch (2026-10-27)

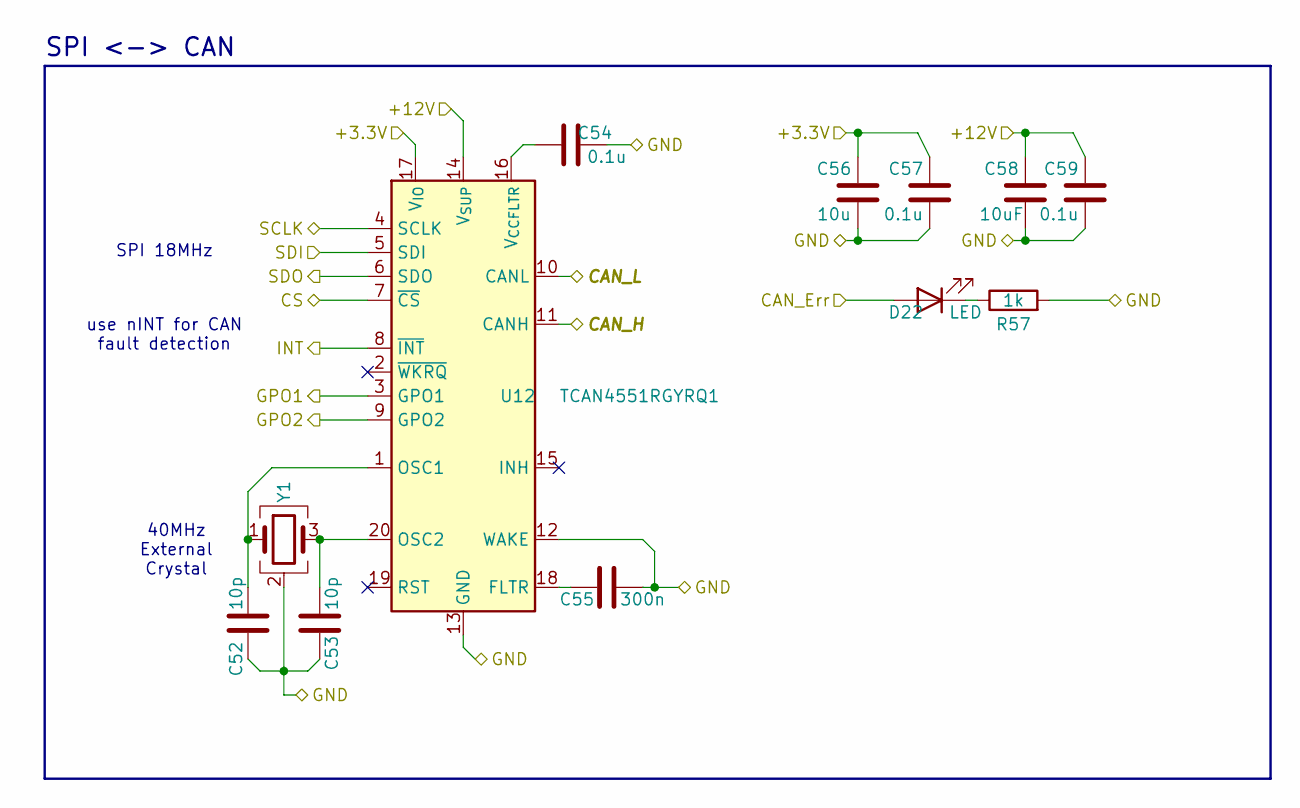
[picture p17: schematic spi_2_can.kicad_sch]

Parts:
C52, C53: 10p
C54, C57, C59: 0.1u
C55: 300n
C56: 10u
C58: 10uF
D22: LED
R57: 1k
U12: TCAN4551RGYRQ1; Texas_RGY_R-PVQFN-N20_EP2.05x3.05mm
Y1: 7M40000005

Connections:
+3.3V: C56.2, C57.2, U12.17 (V_{IO})
+12V: C58.2, C59.2, U12.14 (V_{SUP})
CAN_Err: D22.2 (A)
CAN_H: U12.11 (CANH)
CAN_L: U12.10 (CANL)
CS: U12.7 (~CS)
GND: C52.1, C53.1, C54.1, C55.2, C56.1, C57.1, C58.1, C59.1, R57.2, U12.12 (WAKE), U12.13 (GND), U12.21 (GND), Y1.2 (G), Y1.4 (G)
GPO1: U12.3 (GPO1)
GPO2: U12.9 (GPO2)
INT: U12.8 (~INT)
unnamed: C52.2, U12.1 (OSC1), Y1.1
unnamed: C53.2, U12.20 (OSC2), Y1.3
unnamed: C54.2, U12.16 (V_{CCFLTR})
unnamed: C55.1, U12.18 (FLTR)
unnamed: D22.1 (K), R57.1
SCLK: U12.4 (SCLK)
SDI: U12.5 (SDI)
SDO: U12.6 (SDO)

Notes on the sheet:
SPI <-> CAN
use nINT for CAN fault detection
SPI 18MHz
40MHz External Crystal
