lhr-solar/VCAT-MIKA/Hardware/MIKA/usb_a_3.0.kicad_sch

## KiCad design Hardware/MIKA/usb_a_3.0.kicad_sch (2026-10-27)

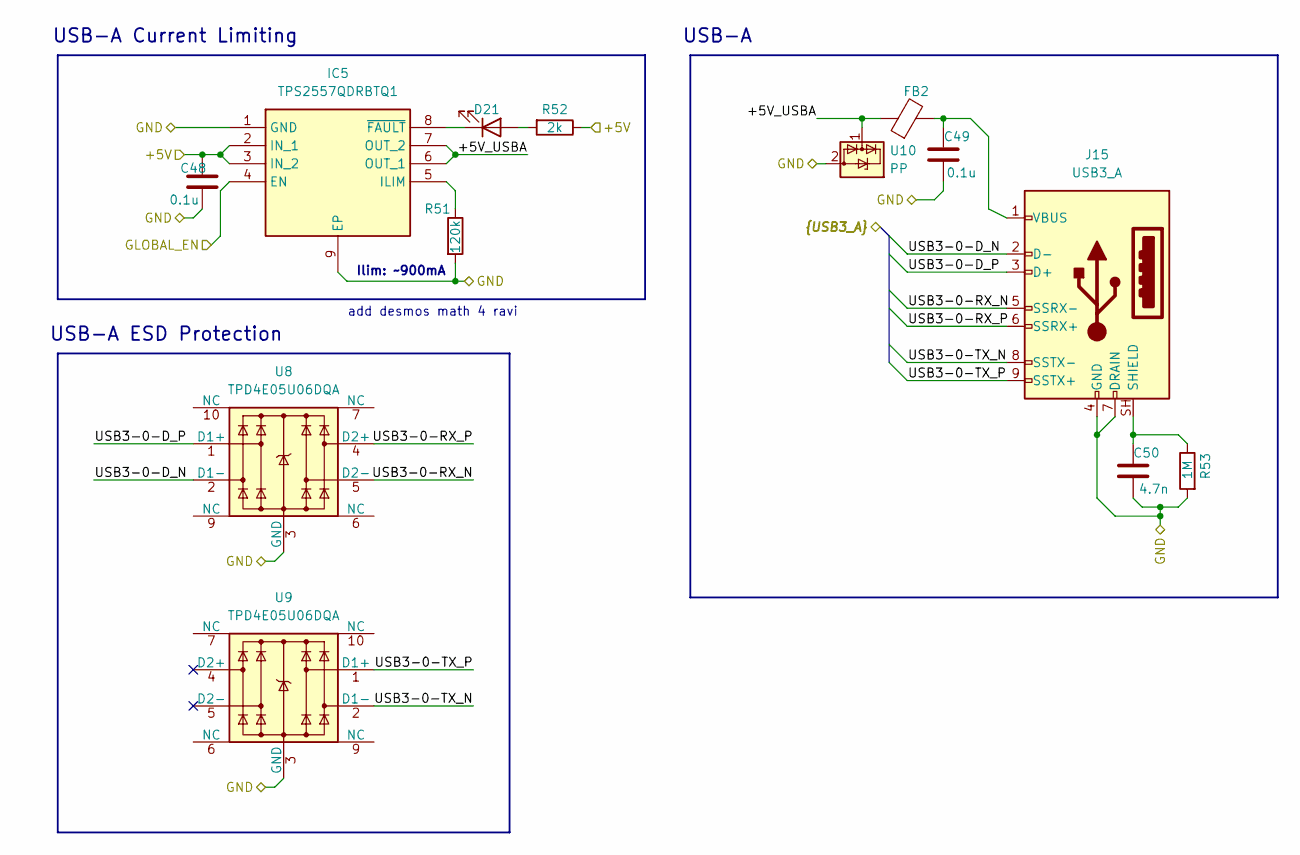
[picture p18: schematic usb_a_3.0.kicad_sch]

Parts:
C48, C49: 0.1u
C50: 4.7n
D21: LED
FB2: FerriteBead
IC5: TPS2557QDRBTQ1; SON65P300X300X100-9N-D; Mouser Part Number 595-TPS2557QDRBTQ1
J15: USB3_A
R51: 120k
R52: 2k
R53: 1M
U8, U9: TPD4E05U06DQA; USON-10_2.5x1.0mm_P0.5mm
U10: PP; D_SOD-523

Connections:
+5V: C48.2, IC5.2 (IN_1), IC5.3 (IN_2), R52.1
+5V_USBA: FB2.1, IC5.6 (OUT_1), IC5.7 (OUT_2), U10.1 (I/O)
GLOBAL_EN: IC5.4 (EN)
GND: C48.1, C49.1, C50.2, IC5.1 (GND), IC5.9 (EP), J15.4 (GND), J15.7 (DRAIN), R51.2, R53.2, U8.3 (GND), U8.8 (GND), U9.3 (GND), U9.8 (GND), U10.2 (GND)
unnamed: C49.2, FB2.2, J15.1 (VBUS)
unnamed: C50.1, J15.SH (SHIELD), R53.1
unnamed: D21.1 (K), IC5.8 (~FAULT)
unnamed: D21.2 (A), R52.2
unnamed: IC5.5 (ILIM), R51.1
USB3-0-D_N: J15.2 (D-), U8.2 (D1-)
USB3-0-D_P: J15.3 (D+), U8.1 (D1+)
USB3-0-RX_N: J15.5 (SSRX-), U8.5 (D2-)
USB3-0-RX_P: J15.6 (SSRX+), U8.4 (D2+)
USB3-0-TX_N: J15.8 (SSTX-), U9.2 (D1-)
USB3-0-TX_P: J15.9 (SSTX+), U9.1 (D1+)

Notes on the sheet:
Ilim: ~900mA
USB-A ESD Protection
USB-A
add desmos math 4 ravi
USB-A Current Limiting
