lhr-solar/VCAT-MIKA/(commit log)

2026-10-13 here ya go my fellas
    [12VBuck.kicad_sch, CM5.kicad_sch, LDO.kicad_sch, MIKA.kicad_sch, PowerProtection.kicad_sch, Power_Mux.kicad_sch, SPI_CAN.kicad_sch, TPS2557QDRBTQ1.stp]
2026-10-14 ugahhghh might be layout time im a lil excited lwk
    [12VBuck.kicad_sch, CM5.kicad_sch, LDO.kicad_sch, MIKA.kicad_sch, PowerProtection.kicad_sch, Power_Mux.kicad_sch, SPI_CAN.kicad_sch, USB-C_Connector.kicad_sch]
2026-10-27 bahasdf;ladjsfhadf boooooooooooshksa
    [12VBuck.kicad_sch, 12V_buck_5A.kicad_sch, CM5.kicad_sch, IMUs.kicad_sch, LDO.kicad_sch, MIKA.kicad_sch, PowerProtection.kicad_sch, Power_Mux.kicad_sch]
2026-10-31 footprint time
    [12V_buck_5A.kicad_sch, CM5.kicad_sch, MIKA.kicad_sch, USB-C_Connector.kicad_sch, power_regulation.kicad_sch]
